gabormay/esp-thermometer/img/gpio16.jpg

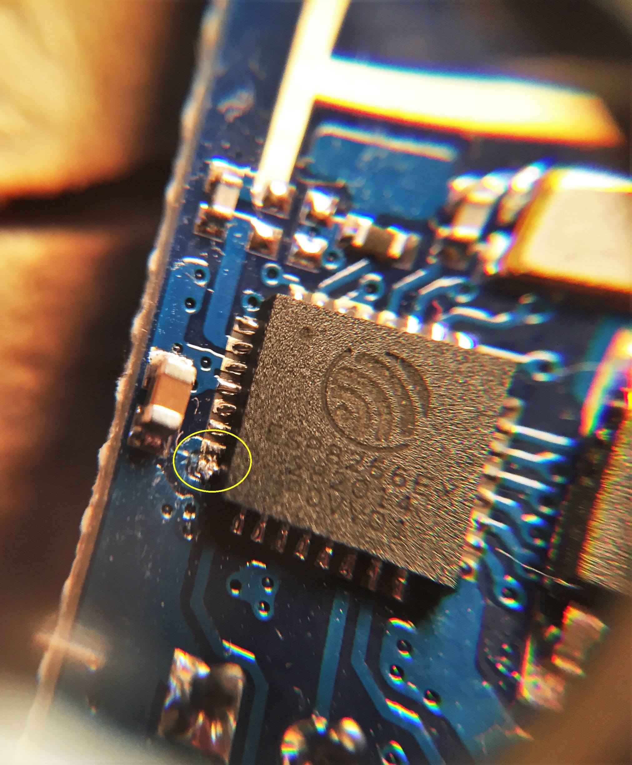
img/gpio16.jpg
