gabormay/esp-thermometer/img/sans-powerled.jpg

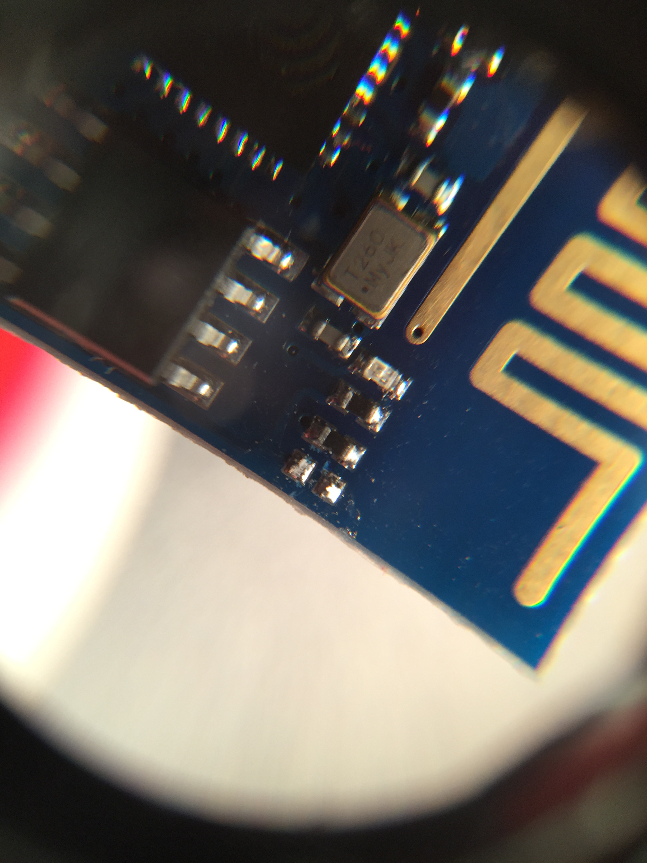
img/sans-powerled.jpg
