gabormay/esp-thermometer/img/Ubidots dashboard.png

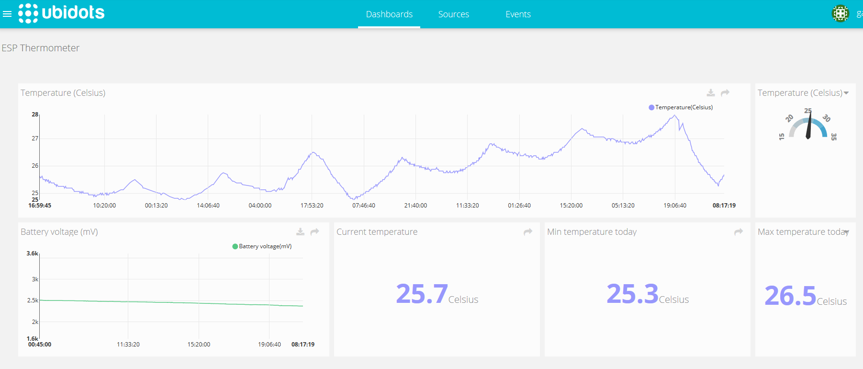
img/Ubidots dashboard.png
