gabormay/esp-thermometer/(commit log)

2016-08-31 schematic and code, initial
2016-08-31 board settings
